krutikdg/smartScale/CAD/assembly.step

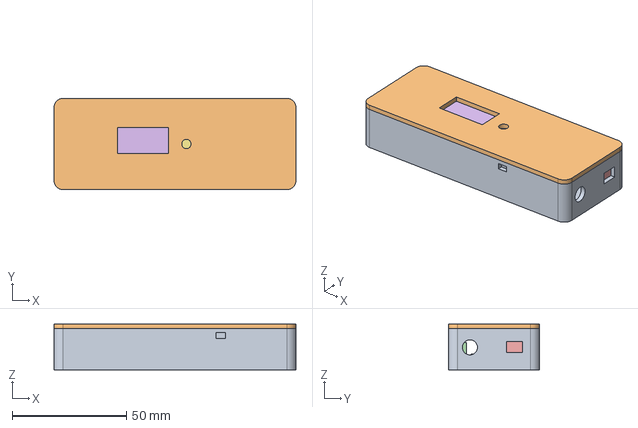
[picture p1: CAD file, 2026-10-31]
CAD/assembly.step
106.0 x 40.0 x 20.0 mm
