krutikdg/smartScale/CAD/lid.stl

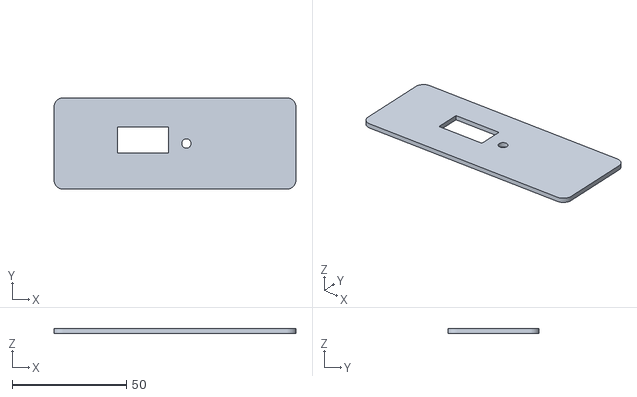
[picture p2: CAD file, 2026-10-31]
CAD/lid.stl
106.0 x 40.0 x 2.00
