krutikdg/smartScale/CAD/base.stl

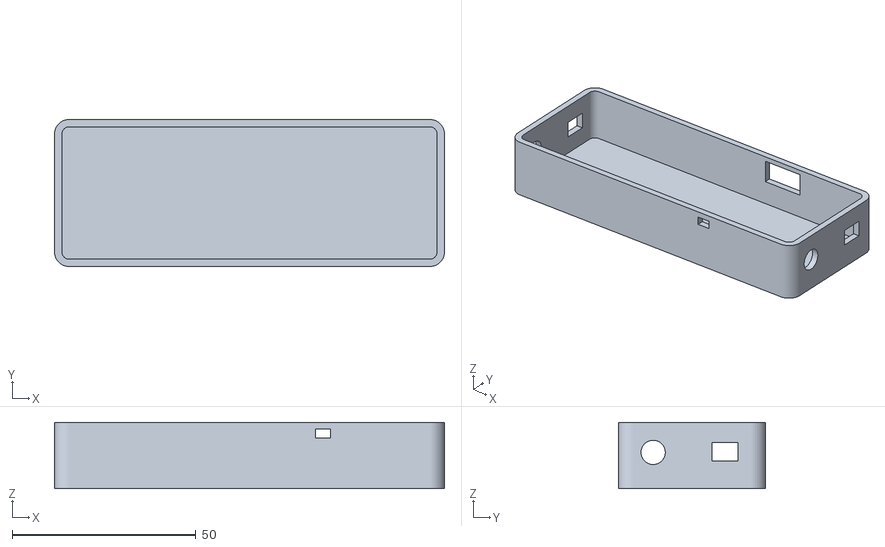
[picture p3: CAD file, 2026-10-31]
CAD/base.stl
106.0 x 40.0 x 18.0
