krutikdg/smartScale/(list of files, cad)

Other CAD files:
CAD/assembly.f3d
