krutikdg/smartScale/(commit log)

2026-10-31 Added CAD models
    [assembly.f3d, assembly.step, base.stl, lid.stl]
2026-11-01 Added BOM and updated README
    [BOM.csv]
2026-11-01 updated BOM and updated README
    [BOM.csv]
2026-11-01 Add CAD models and images to README
    Added CAD models section with images of the lid, base, assembly, and final product.
